ibrohim300/Wearable-monotirng-sapi-indonesia/skema rangkaian wearable dan receiver.PNG

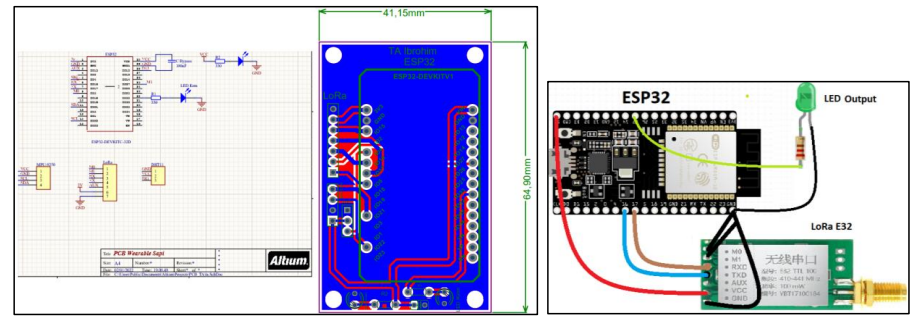
skema rangkaian wearable dan receiver.PNG
