ibrohim300/Wearable-monotirng-sapi-indonesia/dokumentasi.png

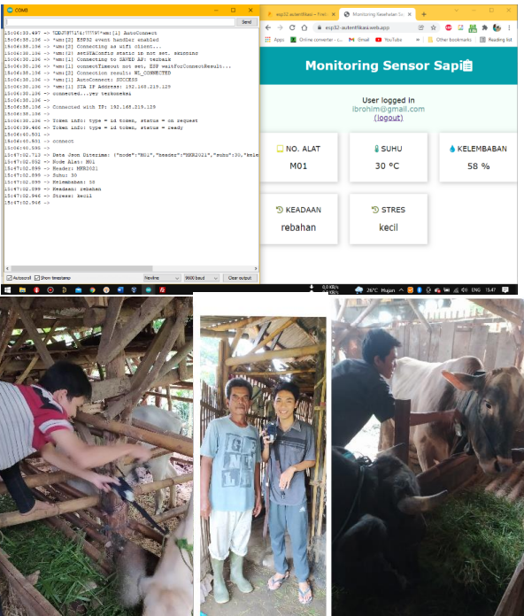
dokumentasi.png
