ibrohim300/Wearable-monotirng-sapi-indonesia/README.md

# Wearable-sapi-indonesia!
Merupakan perangkat werable kalung leher sapi Merupakan perangkat werable kalung leher sapi untuk mendeteksi tingkat stress dan juga posisi rebahan berdirinya sapi
Beberapa fitur dari wearable ini:
- menggunakan komunikasi LoRa E32 sehingga mampu menjangkau jarak 3km seperti pada datasheetnya
- daya tahan uji baterai sampai 18 jam
- perangkat receiver dilengkapi dengan wifimanager, sehingga bebas mengganti wifi tanpa upload program ulang
- pengiriman ke web firebase + script firebasenya. sehingga sangat memudahkan dalam debugging alatnta
Silahkan langsunbg di download saja.
berikut gambar perangkat wearbale dan juga receivernya:
SI_20220109_220849 - Copy
SI_20220109_140857 - Copy
dokumentasi
