ibrohim300/Wearable-monotirng-sapi-indonesia/Diagram Blok 2.png

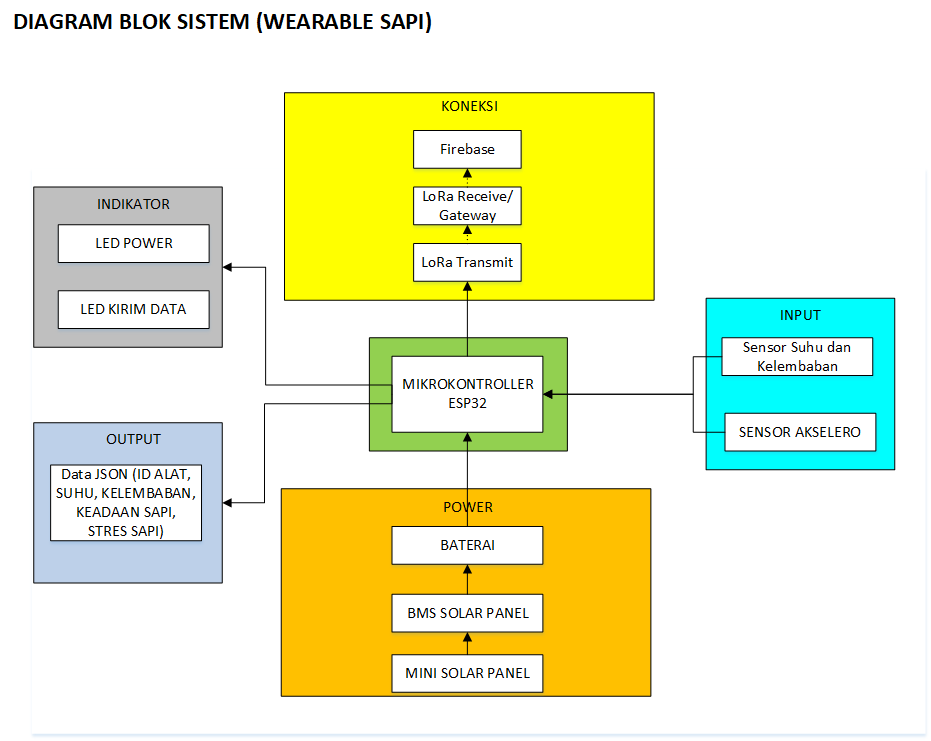
Diagram Blok 2.png
