ibrohim300/Wearable-monotirng-sapi-indonesia/RAB-terbaru.xlsx

 |  |  |  |  |  |  | 2021-11-17
RAB TA - Wearable Kesehatan Sapi dan Receivernya
No | Nama Barang | Spesifikasi | Jumlah | Satuan | Harga Satuan | Total | Keterangan
1 | Microcontroller | esp32 | 2 | pcs | Rp 150000 | Rp 300000 | ada
2 | Sensor Accelero dan Gyro | MPU6050 | 1 | pcs | Rp 20000 | Rp 20000 | ada
3 | LED | 3 mm | 4
4 | SWITCH | Push Switch | 1 | pcs | Rp 3500 | Rp 3500 | usulan
5 | Panel Surya | 5V, 220mA kecil | 1 | pcs | Rp 16000 | Rp 16000 | usulan
6 | Kapasitor | 4,7 uF 16V | 2
7 | Dioda | 1N4007 | 1
8 | Baterai | Lithium 18650 3,7 V | 1 | pcs | Rp 6000 | Rp 6000 | ada
9 | Resistor | 330Ω | 4 | pcs | Rp 100 | Rp 400 | ada
10 | Webbing kanvas dan perekatnya | berbahan katun untuk sabuk ke sapi | 1 | pcs | Rp 10000 | Rp 10000 | usulan
11 | Modul BMS Solar panel | Output USB input Micro USB dan Baterai | 1 | pcs | Rp 13000 | Rp 13000 | usulan
12 | Modul DHT11 | Suhu dan Kelembaban | 1 | pcs | Rp 20000 | Rp 20000 | ada
12 | LoRa | e32 | 2 | pcs | Rp 250000 | Rp 500000 | ada
14 | Kabel Jumper | Male to Female | 1 | pcs | Rp 5000 | Rp 5000 | ada
15 | Header | Female 1x10 | 1 | pcs | Rp 1500 | Rp 1500 | ada
16 |  | Male Panjang 1x40 | 1 | pcs | Rp 2600 | Rp 2600 | ada
17 | PCB Wearable | 41,15x64,90 mm | 2 | pcs | Rp 50000 | Rp 100000 | usulan
18 | BOX (Receiver) | 11x8x4,7 cm | 1 | pcs
19 | BOX (WEARABLE) | 12x6x4 | 1 | pcs | Rp 10000 | Rp 10000 | usulan
 |  |  |  | HARGA TOTAL |  | Rp 1008000
 | Source | Shopee |  | OVERHEAD 10% |  | Rp 100800
 |  |  |  | Total |  | Rp 1108800
