ibrohim300/Wearable-monotirng-sapi-indonesia/(commit log)

2022-01-18 menambahkan file pcb
2022-01-18 Gambaran skema pcb wearable dan skema receivernya
2022-01-18 add Rab and maping pin
    [Pin Mapping Cow Receiver fix.xlsx, Pin Mapping Wearable Sapi Fix.xlsx, RAB-terbaru.xlsx]
